lily-osp/PID_simple_controll/archived/PCB/data/JYQD_V7.3E原理图.pdf

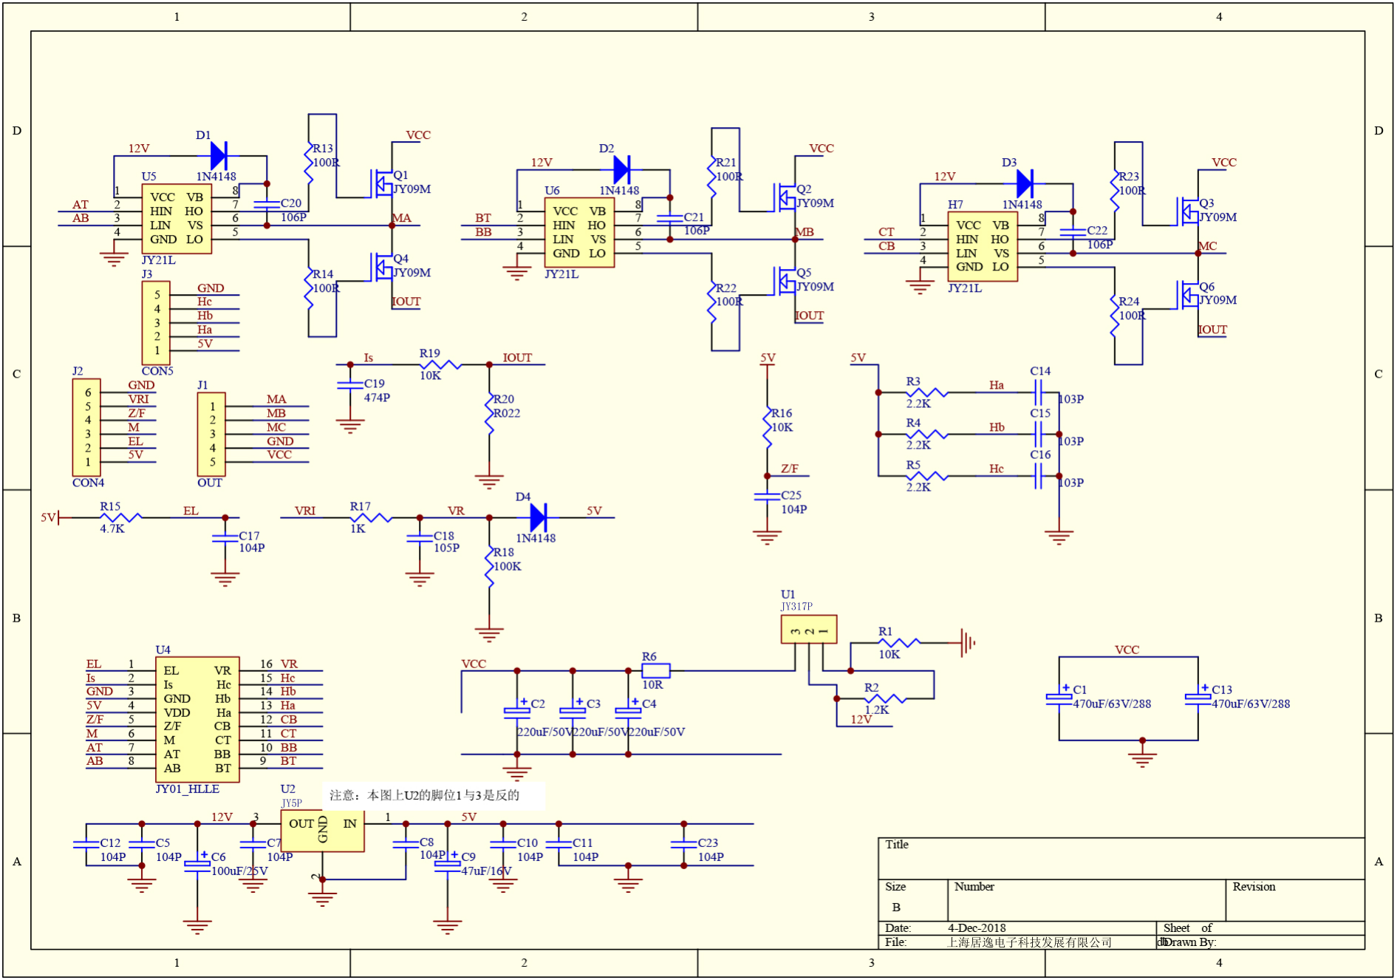
[picture p1: page 1]

JY317P

上海居逸电子科技发展有限公司

JY5P
