lily-osp/PID_simple_controll/PCB/V1/render/routed_bottom.png

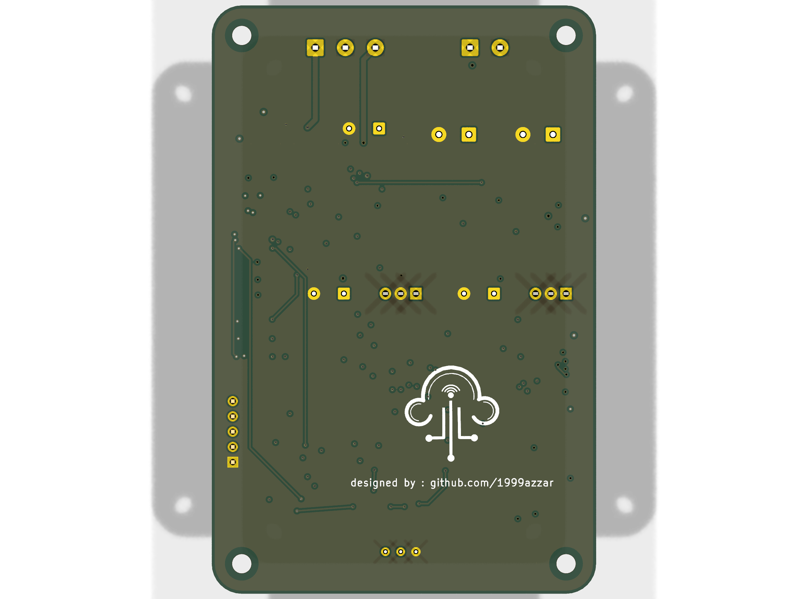
PCB/V1/render/routed_bottom.png
