lily-osp/PID_simple_controll/PCB/bldc_esp32_driver/fab/ORDER.md

# Fabrication order — bldc_esp32_driver

| Parameter | Value |
|---|---|
| Size | 70 x 120 mm |
| Layers | 2 (F.Cu / B.Cu) |
| Thickness | 1.6 mm |
| Copper | **2oz** |
| Surface finish | HASL lead-free |
| Soldermask | green (any) |
| Silkscreen | white |
| Min track / clearance | 0.2 mm / 0.2 mm |
| Min drill | 0.3 mm |
| Mounting holes | 4 x 3.2 mm NPTH (M3), non-plated |
| Edge clearance | 0.5 mm |

Gerbers: `bldc_esp32_driver_gerbers.zip` (drill files included).
Assembly positions: `positions.csv` (mm, drill origin).
