lily-osp/PID_simple_controll/PCB/V1/fab/bom_jlcpcb.csv

Comment | Designator | Footprint | LCSC Part #
470uF/63V | C1,C2 | Capacitor_THT:CP_Radial_D13.0mm_P5.00mm | C47344187
220uF/50V | C3-C5 | Capacitor_THT:CP_Radial_D10.0mm_P5.00mm | C165644
100nF | C6,C16-C18 | Capacitor_SMD:C_0805_2012Metric | C49678
100nF/50V | C11,C19,C20 | Capacitor_SMD:C_0805_2012Metric | C49678
10uF/25V | C12 | Capacitor_SMD:C_0805_2012Metric | C15850
1uF/50V | C13-C15 | Capacitor_SMD:C_0805_2012Metric | C28323
10nF | C21 | Capacitor_SMD:C_0805_2012Metric | C1710
1N4148 | D1-D3 | Diode_SMD:D_SOD-123 | C2099
PWR | LED1 | LED_SMD:LED_0805_2012Metric | C84256
ERR | LED2 | LED_SMD:LED_0805_2012Metric | C84256
JY2605 | Q2-Q4 | local:JY2605M_DFN8_5x6
R005_2512 | R1 | Resistor_SMD:R_2512_6332Metric | C2903482
2.2k | R4 | Resistor_SMD:R_0805_2012Metric | C17520
3.3k | R5 | Resistor_SMD:R_0805_2012Metric | C204416
100R | R7-R13 | Resistor_SMD:R_0805_2012Metric | C17408
15R | R14-R19 | Resistor_SMD:R_0805_2012Metric | C20142755
560R | R20,R32 | Resistor_SMD:R_0805_2012Metric | C5576051
10k | R21-R23,R25-R27,R33,R35 | Resistor_SMD:R_0805_2012Metric | C17414
1k | R29-R31,R34,R36 | Resistor_SMD:R_0805_2012Metric | C2073872
10K | RV1 | Potentiometer_THT:Potentiometer_Bourns_3296W_Vertical | C34846
JY01(8559) | U1 | Package_SO:SOP-16_3.9x9.9mm_P1.27mm
JY213L | U3 | Package_SO:TSSOP-20_4.4x6.5mm_P0.65mm
LM324 | U4 | Package_SO:SOIC-14_3.9x8.7mm_P1.27mm | C127953
74HC14 | U5 | Package_SO:SOIC-14_3.9x8.7mm_P1.27mm | C130461
7805 | U7 | Package_TO_SOT_THT:TO-220-3_Vertical | C111887
7812 | U8 | Package_TO_SOT_THT:TO-220-3_Vertical | C105651
