lily-osp/PID_simple_controll/docs/motor_specification/42BLF20 criterion - Brushless motor.pdf

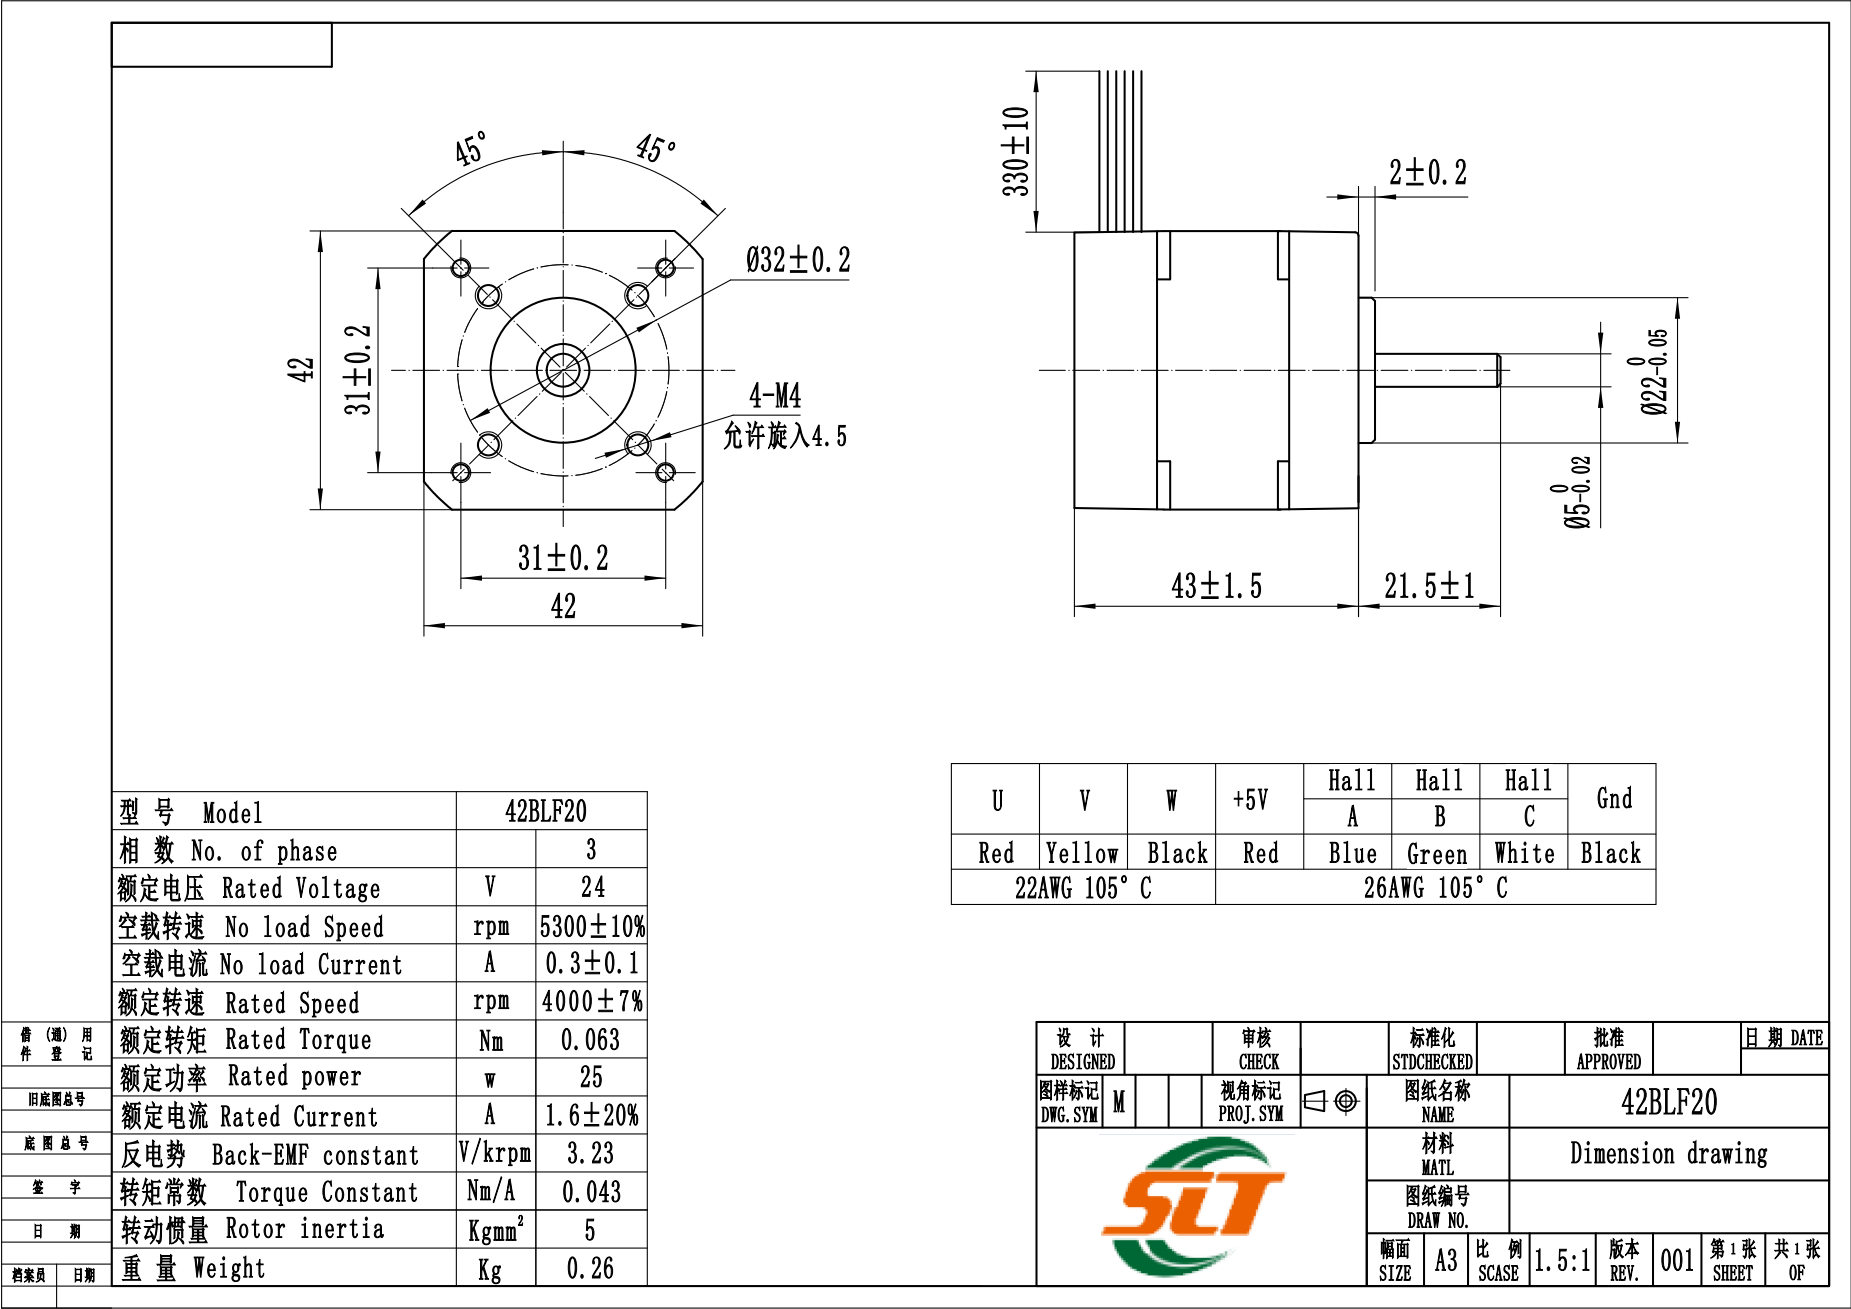
[picture p6: page 1]
