lily-osp/PID_simple_controll/archived/PCB/data/JYQD_ZSX7.0 schematic diagram.pdf

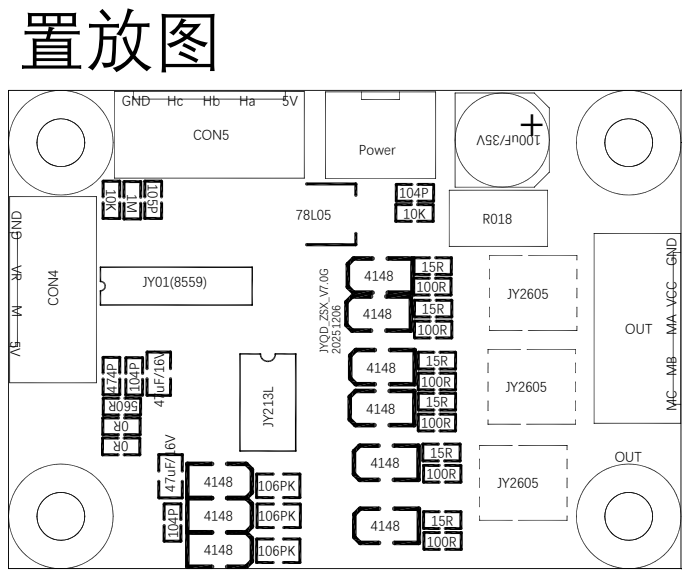
[picture p7: page 1]
OUT; GND VCC; VR GND M 5V 0R0R; 47uF/16V Power 560R; 47uF/16V 106PK 106PK 106PK OUT R018 78L05 JY01(8559); CON4 CON5 4148 4148 4148 4148 4148 4148 置放图

JYQD_ZSX_V7.0G GND Hc Hb Ha 5V
