lily-osp/PID_simple_controll/PCB/V1/bldc_esp32_driver.kicad_pcb

## KiCad design PCB/V1/bldc_esp32_driver.kicad_pcb (2026-11-04)

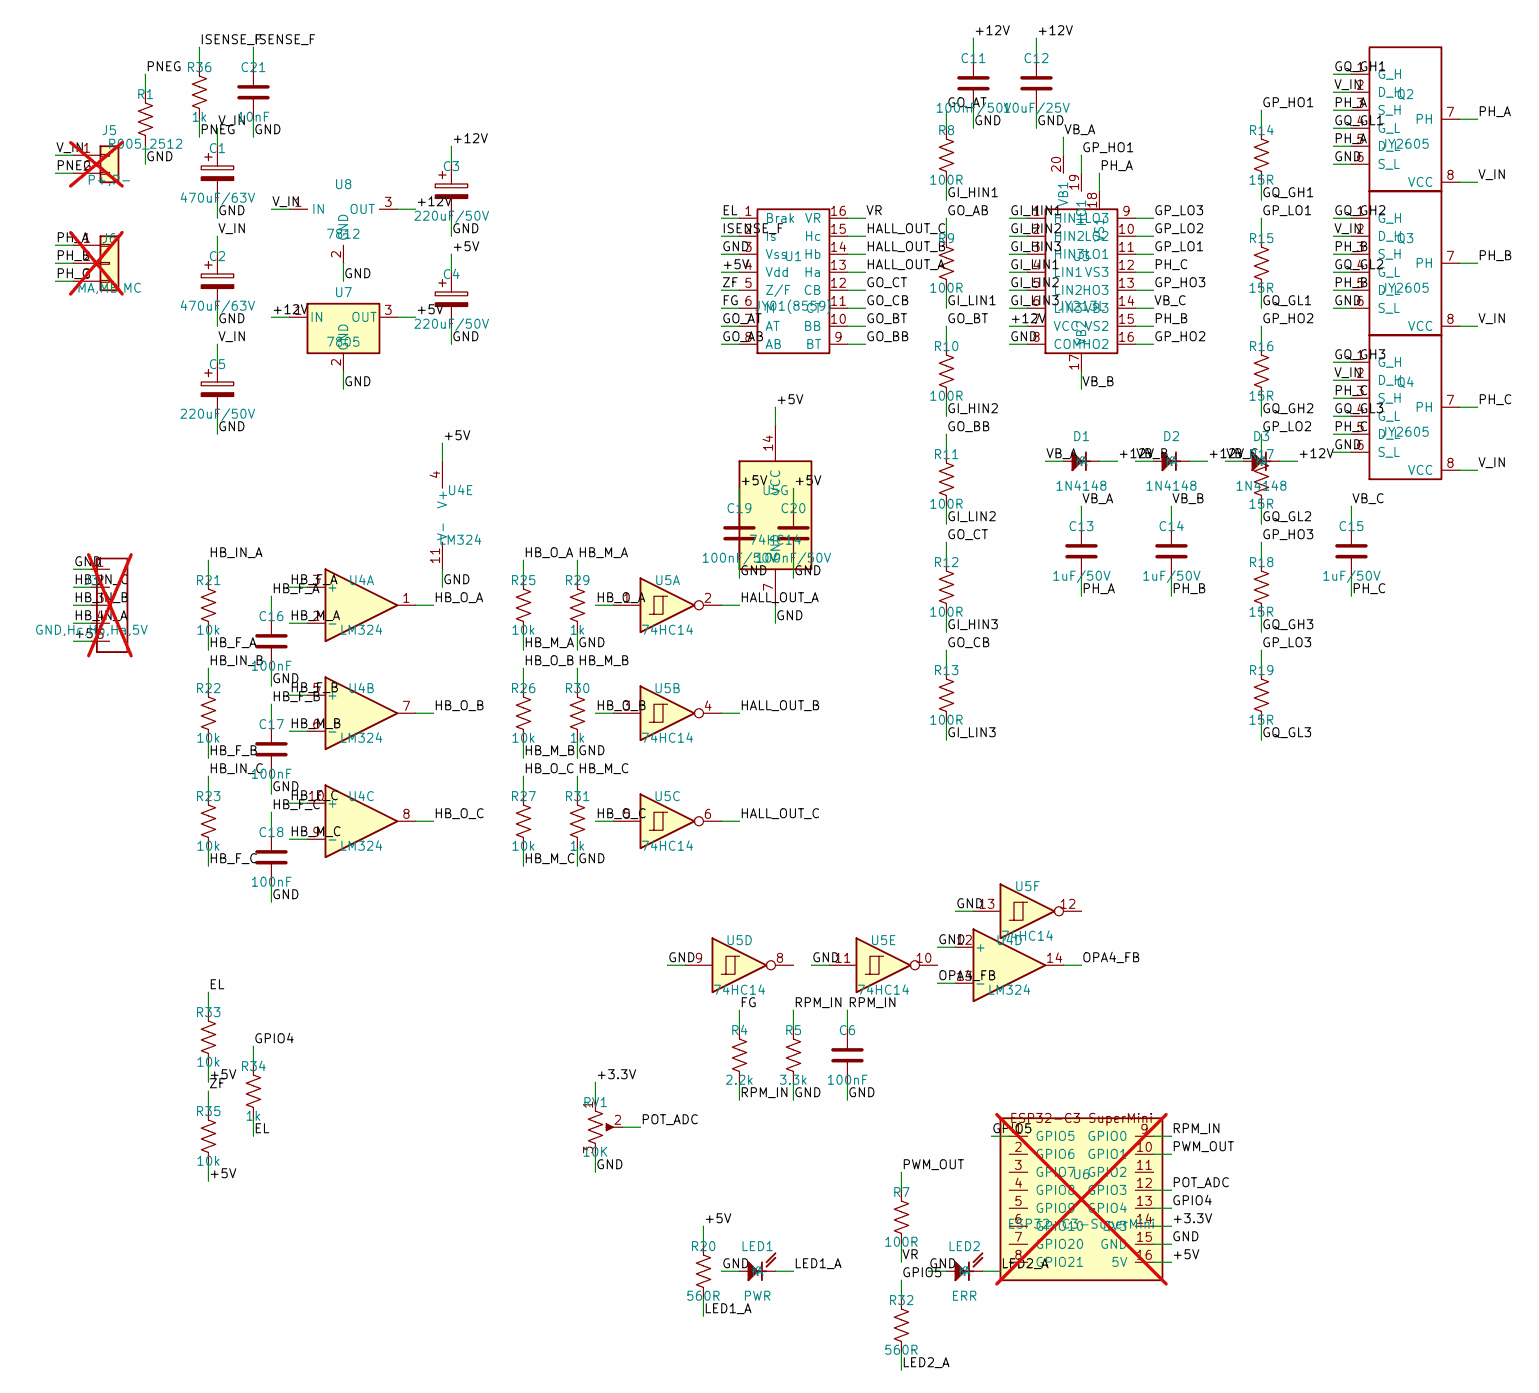
[picture p8: schematic bldc_esp32_driver.kicad_sch, BLDC ESP32-C3 Full-Integration Driver (JYQD-V7.3E3 architec…]

Parts:
C1, C2: 470uF/63V; CP_Radial_D13.0mm_P5.00mm
C3, C4, C5: 220uF/50V; CP_Radial_D10.0mm_P5.00mm
C6, C16, C17, C18: 100nF; C_0805_2012Metric
C11, C19, C20: 100nF/50V; C_0805_2012Metric
C12: 10uF/25V; C_0805_2012Metric
C13, C14, C15: 1uF/50V; C_0805_2012Metric
C21: 10nF; C_0805_2012Metric
D1, D2, D3: 1N4148; D_SOD-123
J3: GND,Hc,Hb,Ha,5V; PinHeader_1x05_P2.54mm_Vertical; not fitted
J5: P+,P-; TerminalBlock_MaiXu_MX126-5.0-02P_1x02_P5.00mm; not fitted
J6: MA,MB,MC; TerminalBlock_MaiXu_MX126-5.0-03P_1x03_P5.00mm; not fitted
LED1: PWR; LED_0805_2012Metric
LED2: ERR; LED_0805_2012Metric
Q2, Q3, Q4: JY2605; JY2605M_DFN8_5x6
R1: R005_2512; R_2512_6332Metric
R4: 2.2k; R_0805_2012Metric
R5: 3.3k; R_0805_2012Metric
R7, R8, R9, R10, R11, R12, R13: 100R; R_0805_2012Metric
R14, R15, R16, R17, R18, R19: 15R; R_0805_2012Metric
R20, R32: 560R; R_0805_2012Metric
R21, R22, R23, R25, R26, R27, R33, R35: 10k; R_0805_2012Metric
R29, R30, R31, R34, R36: 1k; R_0805_2012Metric
RV1: 10K; Potentiometer_Bourns_3296W_Vertical
U1: JY01(8559); SOP-16_3.9x9.9mm_P1.27mm
U3: JY213L; TSSOP-20_4.4x6.5mm_P0.65mm
U4: LM324; SOIC-14_3.9x8.7mm_P1.27mm
U5: 74HC14; SOIC-14_3.9x8.7mm_P1.27mm
U6: ESP32-C3-SuperMini; not fitted
U7: 7805; TO-220-3_Vertical
U8: 7812; TO-220-3_Vertical

Connections:
+3.3V: RV1.1, U6.14 (3V3)
+5V: C4.1, C19.1, C20.1, J3.5, R20.1, R33.2, R35.2, U1.4 (Vdd), U4.4 (V+), U5.14 (VCC), U6.16 (5V), U7.3 (OUT)
+12V: C3.1, C11.1, C12.1, D1.2 (A), D2.2 (A), D3.2 (A), U3.7 (VCC), U7.1 (IN), U8.3 (OUT)
EL: R33.1, R34.2, U1.1 (Brak)
FG: R4.1, U1.6 (M)
GI_HIN1: R8.2, U3.1 (HIN1)
GI_HIN2: R10.2, U3.2 (HIN2)
GI_HIN3: R12.2, U3.3 (HIN3)
GI_LIN1: R9.2, U3.4 (LIN1)
GI_LIN2: R11.2, U3.5 (LIN2)
GI_LIN3: R13.2, U3.6 (LIN3)
GND: C1.2, C2.2, C3.2, C4.2, C5.2, C6.2, C11.2, C12.2, C16.2, C17.2, C18.2, C19.2, C20.2, C21.2, J3.1, LED1.1 (K), LED2.1 (K), Q2.6 (S_L), Q3.6 (S_L), Q4.6 (S_L), R1.2, R5.2, R29.2, R30.2, R31.2, RV1.3, U1.3 (Vss), U3.8 (COM), U4.11 (V-), U4.12 (+), U5.7 (GND), U5.9, U5.11, U5.13, U6.15 (GND), U7.2 (GND), U8.2 (GND)
GO_AB: R9.1, U1.8 (AB)
GO_AT: R8.1, U1.7 (AT)
GO_BB: R11.1, U1.9 (BT)
GO_BT: R10.1, U1.10 (BB)
GO_CB: R13.1, U1.11 (CT)
GO_CT: R12.1, U1.12 (CB)
GPIO4: R34.1, U6.13 (GPIO4)
GPIO5: R32.1, U6.1 (GPIO5)
GP_HO1: R14.1, U3.19 (HO1)
GP_HO2: R16.1, U3.16 (HO2)
GP_HO3: R18.1, U3.13 (HO3)
GP_LO1: R15.1, U3.11 (LO1)
GP_LO2: R17.1, U3.10 (LO2)
GP_LO3: R19.1, U3.9 (LO3)
GQ_GH1: Q2.1 (G_H), R14.2
GQ_GH2: Q3.1 (G_H), R16.2
GQ_GH3: Q4.1 (G_H), R18.2
GQ_GL1: Q2.4 (G_L), R15.2
GQ_GL2: Q3.4 (G_L), R17.2
GQ_GL3: Q4.4 (G_L), R19.2
HALL_OUT_A: U1.13 (Ha), U5.2
HALL_OUT_B: U1.14 (Hb), U5.4
HALL_OUT_C: U1.15 (Hc), U5.6
HB_F_A: C16.1, R21.2, U4.3 (+)
HB_F_B: C17.1, R22.2, U4.5 (+)
HB_F_C: C18.1, R23.2, U4.10 (+)
HB_IN_A: J3.4, R21.1
HB_IN_B: J3.3, R22.1
HB_IN_C: J3.2, R23.1
HB_M_A: R25.2, R29.1, U4.2 (-)
HB_M_B: R26.2, R30.1, U4.6 (-)
HB_M_C: R27.2, R31.1, U4.9 (-)
HB_O_A: R25.1, U4.1, U5.1
HB_O_B: R26.1, U4.7, U5.3
HB_O_C: R27.1, U4.8, U5.5
ISENSE_F: C21.1, R36.1, U1.2 (Is)
LED1_A: LED1.2 (A), R20.2
LED2_A: LED2.2 (A), R32.2
OPA4_FB: U4.13 (-), U4.14
PH_A: C13.2, J6.1, Q2.3 (S_H), Q2.5 (D_L), Q2.7 (PH), U3.18 (VS1)
PH_B: C14.2, J6.2, Q3.3 (S_H), Q3.5 (D_L), Q3.7 (PH), U3.15 (VS2)
PH_C: C15.2, J6.3, Q4.3 (S_H), Q4.5 (D_L), Q4.7 (PH), U3.12 (VS3)
PNEG: J5.2, R1.1, R36.2
POT_ADC: RV1.2, U6.12 (GPIO3)
PWM_OUT: R7.1, U6.10 (GPIO1)
RPM_IN: C6.1, R4.2, R5.1, U6.9 (GPIO0)
VB_A: C13.1, D1.1 (K), U3.20 (VB1)
VB_B: C14.1, D2.1 (K), U3.17 (VB2)
VB_C: C15.1, D3.1 (K), U3.14 (VB3)
VR: R7.2, U1.16 (VR)
V_IN: C1.1, C2.1, C5.1, J5.1, Q2.2 (D_H), Q2.8 (VCC), Q3.2 (D_H), Q3.8 (VCC), Q4.2 (D_H), Q4.8 (VCC), U8.1 (IN)
ZF: R35.1, U1.5 (Z/F)

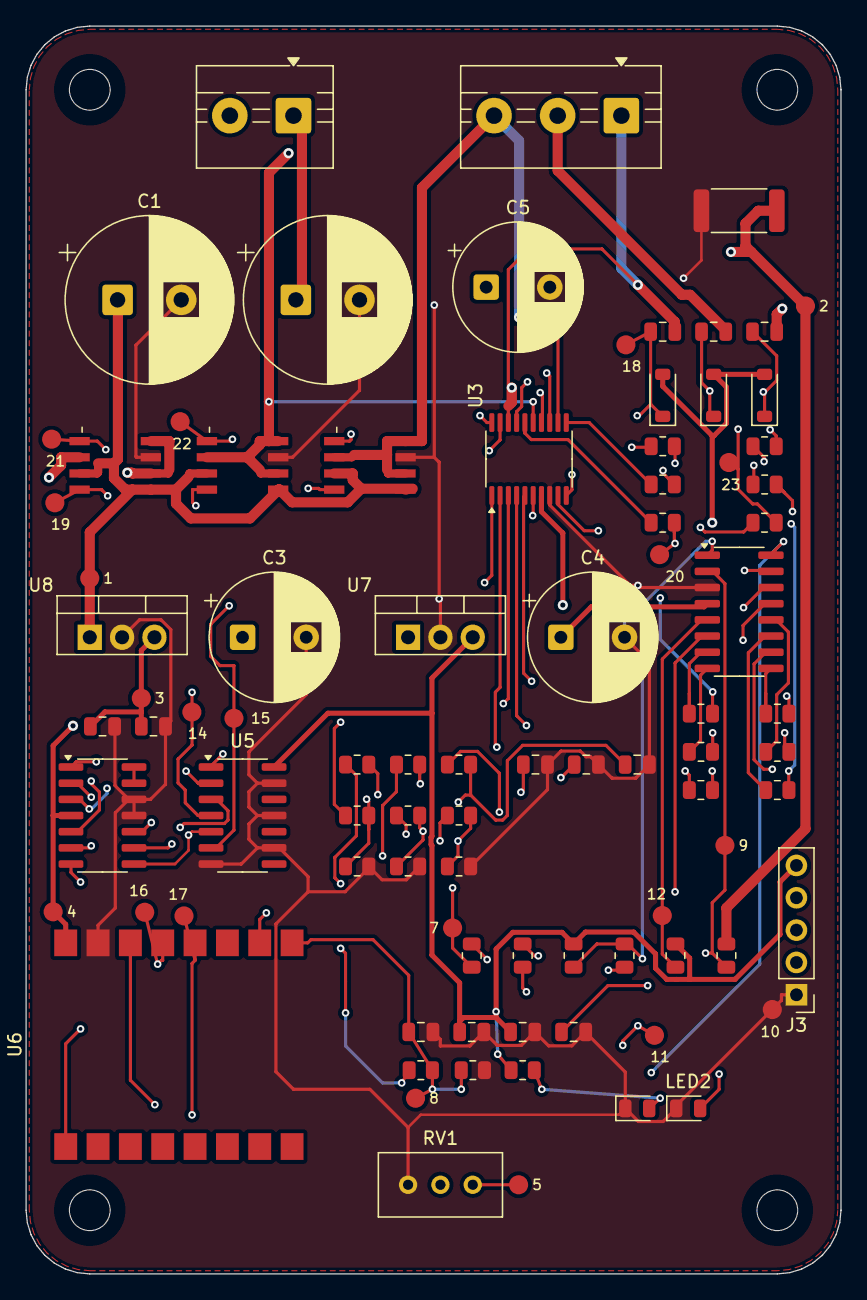
[picture p9: board bldc_esp32_driver.kicad_pcb from above]

Board: 4 copper layers, 64.0 x 98.0 mm, 92 parts (0 on the bottom side), 64 nets.

Other parts of the board:
H1, H2, H3, H4: MountingHole_3.2mm_M3
TP1, TP2, TP3, TP4, TP5, TP7, TP8, TP9, TP10, TP11, TP12, TP14, TP15, TP16, TP17, TP18, TP19, TP20, TP21, TP22, TP23: (no value)
