lily-osp/PID_simple_controll/(commit log)

2026-09-09 attiny85: v4 deadband+oversampling PID, ATTinyCore migration, spin test
    - v4: v1 spin path + loop-side 4x oversampling + 30rpm deadband,
    startup kick, PB1 pulse heartbeat debug, no failsafe clutter
    - migrate build_all/flash/compile_test and Makefiles to ATTinyCore
    (damellis 1.0.2 no longer compiles); flash defaults to v4
    - spin_test: open-loop pulse/PWM hardware checkout sketch
    [config.h, config_common.h, isr_common.h, pid_common.h, rpm_common.h, spin_test.ino, v4.ino]
2026-09-09 docs: add ATtiny85 pinout diagram + VR RC-filter note to root README
2026-09-14 esp32-c3: scope to fixed-target PID, JYQD wiring docs, cleanup
    - PID now dt-correct with output directly in PWM units, derivative
    on measurement; retuned gains (KP 0.15 / KI 0.12 / KD 0.004)
    - ESC arming (2s) + 1.5s soft-start in control.ino
    - RPM filter reduced to 12-sample window + IIR 0.45
    - esp32-c3 README: full JYQD-V7.3E3 + 42BLF wiring, merged and
    removed control/README.md
    - Remove control_ble/, simulator/, PCB/, stale assets; archive PCB
    under archived/, add controller/motor spec docs
2026-10-18 esp32-c3: fix motor commutation, measure speed properly, add production build
    The motor would not run reliably: jitter, weak torque, and it stopped under
    a finger. Four separate faults, found in order.
    1. Hall line sequence
    The JYQD datasheet notes Hall sequences vary between manufacturers and may
    need transposing. Ours did not match. Swapping Ha and Hb at the driver took
    pulse throughput from 91 to 2,374 per capture window, peak speed from 566 to
    1,855 RPM, and jitter from 29.6% to 10.8%.
    2. PULSES_PER_REV was 4, should be 12
    Signal is the XOR of three 120 deg Halls, so it gives 3 x pole_pairs cycles
    per mechanical revolution. 42BLF is 8 poles = 4 pole pairs => 12. The o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
2026-10-30 remove non-ESP32 platform variants; repo is now ESP32-C3 only
    - Remove arduino_uno/, attiny85/ (v1-v4), archived/ legacy content
    - Remove backups/ (attiny85 snapshots) from disk
    - Track PCB/bldc_esp32_driver: the new controller+driver board design
    (JYQD-V7.3E3 architecture + ESP32-C3 Super Mini + Hall amp)
    - Trim README, docs (howto, index, mitigation), CONTRIBUTING, CI workflow
    to ESP32-C3 only; drop docs/COMPARISON.md (single platform)
    - CI now compiles esp32-c3 control + embedded builds only
    - All removed content is preserved on the archive/all-variants branch
2026-10-30 docs(conductor): update tech-stack to ESP32-only reality (control/embedded builds, bldc_esp32_driver PCB)
2026-10-30 pcb(bldc_esp32_driver): sync latest generated schematic + board (TSSOP-20 JY213L placement update)
2026-10-31 pcb(bldc_esp32_driver): fully routed board on user placement (0 unconnected, 0 copper DRC) + renders + routing tools
    - Board wired on the user's hand-arranged 69-component placement (moved on-page, origin ~x91/y44)
    - FreeRouting 2.5.0 on Java 25 JRE: 0 unrouted / 0 violations in 62s (v1.9 optimizer wedges on this density)
    - 1277 traces, 142 vias, solid GND pour F.Cu + B.Cu; DRC clean except 5 cosmetic silk warnings
    - 0-ohm jumper allowance kept, unused
    - Add renders (top/bottom/zoom), routing tools (setup_netclasses, fix_dsn_classes, add_gnd_pour2, export_dsn, widen_power), README status refresh
2026-11-02 pcb(bldc_esp32_driver): finalize board — DRC-clean, widened power copper, fab package
    Verification (this exact board):
    - DRC: 0 violations, 0 unconnected items (--severity-all)
    - Schematic parity: 268 reported items, 0 genuine (root-sheet '/' prefix and
    library-prefix noise on footprints only) — checked programmatically
    - Outline closed (8 segments, 0 open endpoints), 70.0 x 120.0 mm, 0 pads outside
    - 1277 traces / 4510 mm, 142 vias, 2 GND pours, 69 footprints
    Copper sizing, measured with the DRC as oracle:
    - V_IN / PNEG uniform 0.80 mm
    - +12V / +5V average 0.57 mm
    - phases: avg 0.33-0.39 mm, up to 0.80 mm; only 1-2% of length below 0.25 mm
    - a fine 0.05 mm-step pass cannot raise more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
2026-11-02 pcb(bldc_esp32_driver): fix bootstrap cap voltage rating found in pre-order audit
    C13-C15 were 10uF/25V on the VB_x rails. Those rails float on the phase and
    peak at V_IN + (V_+12V - Vf) ~= V_IN + 11.3V, i.e. 23.3V at the intended 12V
    input (93% of rating) and 35.3V at 24V input, where the part fails short.
    - C13/C14/C15: 10uF/25V -> 1uF/50V (also the correct bootstrap value;
    gate-charge droop ~50mV per cycle). Same 0805 land, no layout change.
    - C12 on +12V: 10uF -> 10uF/25V (was unrated)
    - C11/C19/C20: 100nF -> 100nF/50V (explicit rating)
    Adds tools/set_values.py (reference-addressed schematic value edits) and a
    'Pre-order audit' README section with the pass table plus the four open
    is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
2026-11-02 pcb+firmware: move trim pot off the ESP32-C3 strapping pin, add M3 holes
    The pre-order audit found the trim pot on GPIO2, one of the three ESP32-C3
    strapping pins (GPIO2/8/9), which must be high or floating at reset. RV1 pulled
    it to 0 V at the low end of travel, so a power cycle with the pot turned down
    could land in joint-download boot instead of running firmware. Firmware also
    expected POT_ENABLE on GPIO3 while the board left GPIO3 unconnected, so the pot
    did nothing at all.
    Board:
    - POT_ADC moved from U6 pin 11 (GPIO2) to pin 12 (GPIO3, ADC1_CH3, not a
    strapping pin). Only the final 1.31 mm stub was rerouted; the 20 mm trunk is
    untouched. GPIO2 is left floating, which is the state i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
2026-11-02 pcb(bldc_esp32_driver): v2 — 64x98 mm 4-layer board, phases at 0.75 mm
    Shrinks the board 25% in area (70x120 -> 64x98, 8400 -> 6272 mm2) by moving to
    4 layers with In1 reserved as a solid GND plane. The extra signal layer (In2)
    removes the 2-layer clearance wall that capped the phase copper, so the phases
    go from 0.33-0.39 mm to 0.74-0.77 mm average at the same 0.25 mm neck.
    Placement is a new floor plan, not a rescale: power chain down the left edge
    (J5 -> bulk caps -> 7812 -> 7805), half-bridges under J6, gate driver offset
    from the FET row so its 0.65 mm-pitch sense pins have a fanout corridor, Hall
    amp and ESP32 across the bottom. All three connectors stay on the original
    edges, so th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
2026-11-02 pcb(bldc_esp32_driver): verify and harden the fabrication data
    Checked the actual gerber/drill output rather than trusting the DRC summary:
    - Solder mask: 238 front openings (205 SMD + 29 THT + 4 NPTH) and 33 rear
    (29 THT + 4 NPTH) — matches the pad inventory exactly, negative polarity.
    Mask expansion was 0 and the minimum mask web was unset, so DRC was not
    actually checking slivers. Set expansion 0.05 mm and min web 0.10 mm
    (JLCPCB's limit); still 0 violations, so every web is >= 0.10 mm
    (the 0.65 mm-pitch TSSOP leaves 0.15 mm).
    - Paste: 205 front apertures, 1:1 with the SMD pads; nothing on the rear.
    - Drill: 110 x 0.30, 15 x 0.40, 3 x 0.80, 11 x 1.00, 6 x 1.10, 4 x 1.20,
    5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
2026-11-02 pcb(bldc_esp32_driver): keep designators on the Fab layer, add assembly drawings
    Hiding 61 reference fields to clear the silkscreen warnings left only 12 of 73
    designators visible, which is not assemblable. They are now moved to F.Fab
    instead of being switched off: all 73 are documented, 12 stay on the silkscreen,
    and DRC is still 0/0.
    Also adds fab/assembly_top.pdf and fab/assembly_bottom.pdf (F.Cu/B.Cu + Fab +
    Silk + Edge.Cuts). The 3D render on this machine shows a bare board because no
    KiCad 3D model library is installed -- 0 of the 65 referenced model files exist --
    so the render cannot be used to judge placement. The assembly drawings can.
    Alignment re-verified numerically: every ele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
2026-11-02 pcb(bldc_esp32_driver): real 3D renders, FET stand-in model
    The previous renders were a bare board because no KiCad 3D model library was
    installed (0 of 65 referenced files existed). Installed kicad-packages3d from
    nix, extracted the 16 models the board references (the package ships them as
    zip files named .stpZ, not zstd), and re-rendered with KICAD9_3DMODEL_DIR.
    Renders now show the electrolytics, TO-220s, TSSOP/SOIC ICs, passives and the
    terminal blocks on their pads -- the placement reads correctly.
    Q2/Q3/Q4 now carry a stand-in DFN-8 5.55x5.2 mm model (the library has no 5x6
    DFN-8); it is 1.27 mm pitch like the JY2605M, so it is representative but not
    exact. U6 (ESP32-C3 SuperMini) ha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
2026-11-02 pcb(bldc_esp32_driver): fix undersized copper pours
    The GND pours were built from the old 60x95 outline: 59.5 x 94.5 mm of copper
    on a 64.1 x 98.1 mm board, leaving a 4.3 mm strip along the right edge and
    3.3 mm along the bottom with no copper on any layer.
    Cause: compact_4l.py was updated to 64x98 but import_4l.py kept the 60x95
    constants, and the zones are generated there. DRC never flagged it -- a pour
    that is simply too small is not a violation.
    Rebuilt all four zones from the corrected outline. Margins are now a uniform
    0.55 mm on every edge, and the In1 ground plane covers 91.2% of the board area
    (was ~84%). Copper gerbers regenerated, renders re-shot, DRC still 0/0.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
2026-11-02 pcb(bldc_esp32_driver): install 3D models, representative ESP32 body
    The 'checking_3D_models' plugin reported 68 missing models because
    KICAD9_3DMODEL_DIR pointed at /usr/share/kicad/3dmodels, which does not exist on
    this machine. Fixed properly rather than per-render:
    - Extracted the 17 models this board references from kicad-packages3d into
    ~/.local/share/kicad/3dmodels (the package ships them as zip files named
    .stpZ) and registered KICAD9_3DMODEL_DIR in kicad_common.json, so both the
    GUI and kicad-cli resolve them with no environment override.
    - All 68 model references now resolve.
    - Three models are not in the library and use close substitutes: the two MaiXu
    MX126 terminal bloc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
2026-11-02 pcb: move the board to PCB/V1, re-route after the rotation fixes, add bottom logo
    Structure: PCB/bldc_esp32_driver -> PCB/V1 so a future smaller revision can live
    in PCB/V2 alongside it without disturbing this one.
    Re-route: the placement changed (J3/J5/J6/R1 flipped to 180 deg, C1/C2/C5, the
    FETs, U3 and RV1 moved), so every trace was stale. Cleared all copper and
    re-routed on the 4 layers. FreeRouting left the three U3 phase-sense pins open
    again; planted the fanout by hand first and then routed the gate-drive and
    bootstrap nets around it:
    PH_C straight up onto the In2 trunk
    PH_A up past the C5 pads, across at y=62.05, onto the existing PH_A via
    PH_B via to B.Cu, left, via back o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
2026-11-02 pcb(V1): regenerate all renders from the current board
    routed_bottom.png was from before the re-route and the logo, and
    routed_top_zoom.png was still from the old 70x120 board (31 Oct). Both rebuilt
    from the current 64x98 board, so all three renders now match the committed
    .kicad_pcb (saved 03:49, rendered 03:55-03:58).
    The bottom view now shows the OSP cloud logo and the credit line; the zoom is a
    2.4x view of the hall-amplifier area.
2026-11-02 pcb(V1): assembly variant - exclude ESP32 and all connectors from PCBA
    Ordering assembled, with U6 and the three connectors deliberately unpopulated so
    the user fits the ESP32 and solders wires straight to the pads:
    - Marked DNP + exclude-from-BOM + exclude-from-position in the board, and
    in_bom=no / dnp=yes on the matching schematic symbols so the BOM agrees.
    - fab/bom_jlcpcb.csv 27 lines, JLCPCB columns, excluded parts removed
    - fab/cpl_jlcpcb.csv 65 placements, origin at the board's bottom-left, Y up
    - fab_package.sh now generates both (via tools/make_jlcpcb_assembly.py)
    Also records the blocker found while preparing this: JY01, JY213L and JY2605M
    are not in the LCSC catalogue (Alib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
2026-11-02 pcb(V1): auto-refresh renders in fab_package.sh, fill 20 of 27 LCSC numbers
    fab_package.sh now regenerates the three renders at the end, so render/ can no
    longer drift behind the board.
    LCSC part numbers verified against real LCSC product pages and wired in through
    tools/lcsc_map.csv (20 of 27 BOM lines):
    LM324 C127953, 74HC14 C130461, L7805CV C111887, L7812CV C105651,
    3296W-1-103LF C34846, 1N4148W C2099, LED 0805 red C84256,
    100nF X7R 50V C49678, 10uF/25V X5R C15850, 1uF/50V X7R C28323,
    10nF X7R C1710, 10k C17414, 1k C2073872, 100R C17408, 15R C20142755,
    560R C5576051, 2.2k C17520, 3.3k C204416
    Deliberately left blank rather than guessed: the two electrolytics (lead pitch
    unconf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
2026-11-02 pcb(V1): complete the BOM (24/27), replace U2, add test points + test plan
    BOM: all standard parts now carry a verified LCSC number, 24 of 27 lines.
    Verified through JLCPCB's live parts API rather than web search (which had
    already produced one wrong answer):
    470uF/63V C47344187 D13x21mm 5mm pitch (matches the D13/P5 footprint)
    220uF/50V C165644 D10x12.5mm 5mm pitch (matches D10/P5)
    5mR 2512 C2903482 3W 1% current sense
    2N7002 C8545 SOT-23, JLCPCB basic part
    Only U1/U3/Q2-Q4 remain, and those genuinely are not in the LCSC catalogue.
    U2: replaced CSD13380F3 with 2N7002. The original is a 0.73x0.64mm FemtoFET but
    the footprint is SOT-23-3 -- they cannot be the same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
2026-11-04 docs: bring all documentation up to date with PCB/V1
    Audited every markdown file against the current board and firmware.
    Stale paths: PCB/bldc_esp32_driver -> PCB/V1 in README, docs/index.md,
    conductor/tech-stack.md and esp32-c3/README.md.
    Stale facts:
    - PCB/V1/README.md still opened with 'Custom 70 x 120 mm PCB' and carried the
    old v1/v2 comparison table; now describes the 64 x 98 mm 4-layer board, with
    the previous board as 'tag v1'.
    - Its LCSC section still said 20 of 27 filled and left U2 as an unresolved
    'needs a decision' problem. Now 24 of 27, and U2 is documented as the 2N7002
    replacement with the reason.
    - Component/trace counts corrected (916 traces, 113 vias, 83 footprin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
2026-11-04 pcb(V1)+docs: fix inverted VR drive, add bench wiring guide
    The VR speed input was inverted. The netlist was GPIO1 -> R7 -> U2 gate,
    U2 drain -> VR, with R6 pulling VR to +5V -- an open-drain inverter. The JYQD
    datasheet maps VR 0.1-5V to 0-100% speed, so duty 0% gave 3.3V (about 66%
    speed) and duty 100% gave 0V (stop). The firmware assumes non-inverting, so the
    PID would have run as positive feedback, and at power-up (GPIO1 high-Z) the
    motor would have started by itself.
    Hardware fix, as agreed: U2 and R6 are removed and R7 (100R) now feeds VR
    directly. The datasheet accepts PWM 1-20kHz on VR and averages it internally.
    0% duty = 0V = stop, 100% = 3.3V = about 66% speed (about 2640 RPM on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
2026-11-04 docs: link the bench wiring guide from the README and docs index
2026-11-04 pcb(V1): re-route after the R4/R5/R20 move, add five test points
    R4 moved to (131,122), R5 to (135.09,122) and R20 to (139,122), which put them
    inside the GND stitching fence and broke four nets.
    - GND fence: the vertical run at x=132.53 passed straight through R4 pad 2 (0.02 mm
    of copper overlap, plus a solder-mask bridge). It now drops at x=133.04, in the
    gap between R4 and R5.
    - FG: R4.1 -> B.Cu under the GPIO5 In2 trunk -> the existing divider node at
    (125.088,115). The old via sat on the GPIO5 trunk.
    - RPM_IN: R4.2 -> C6.1 directly, R5.1 -> R4.2 around the fence on B.Cu.
    - LED1_A: R20.2 -> LED1.2 on B.Cu; the old trace hung off R20's previous position.
    - +5V: R20.1 could not be f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
2026-11-04 pcb(V1): keep the re-routed tracks, fix hidden test points, label them
    The routing pass after the R4/R5/R20 move left the zone fills stale: DRC reported
    29 clearance errors against the GND pours, all of them phantom. Refilling the
    zones clears them and the board is 0/0 again.
    Three test points were sitting inside the ESP32 module's courtyard, i.e. under
    the module body, so they could never be probed:
    - TP5 (+3.3V) was at (108.19,122.78) -> now (138.68,131.00), fed from RV1 pin 1.
    - TP8 (RPM_IN) was at (123.39,111.75) -> now (130.59,124.20), fed from the
    divider node.
    - TP13 (GPIO5) is gone: between the module, mounting hole H3 and the board edge
    there is no legal spot left. Probe R32 p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
2026-11-05 docs: add bench wiring reference photo and update guide
